huynguyen6923-hub/Huy_K26/pictures/Screenshot 2026-04-20 142424.png

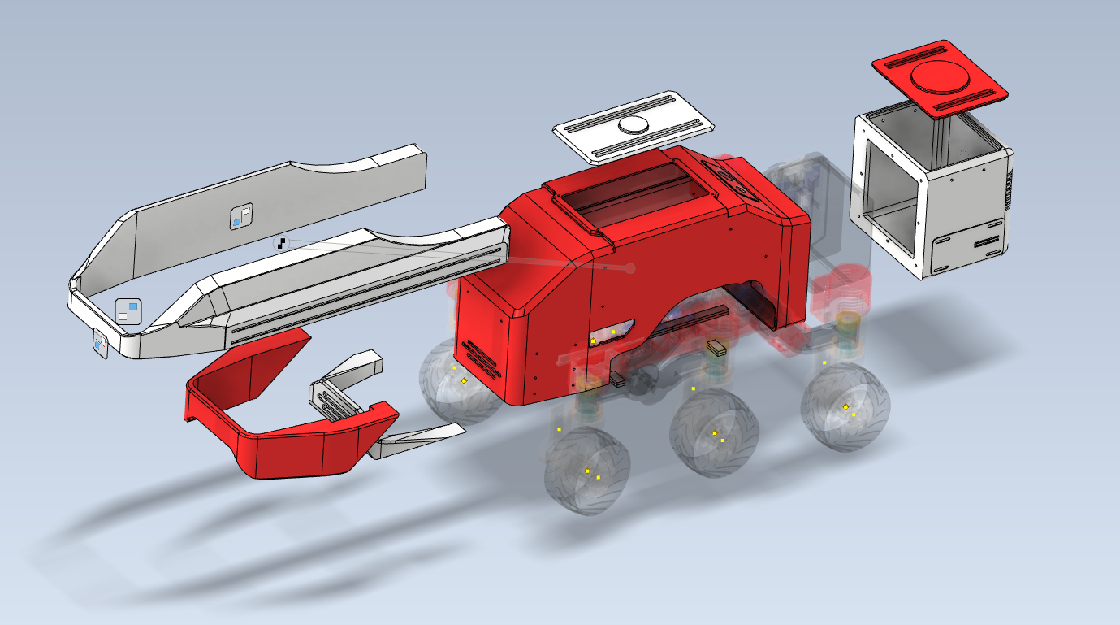
pictures/Screenshot 2026-04-20 142424.png
