huynguyen6923-hub/Huy_K26/(commit log)

2026-01-04 intit project
    [pyvenv.cfg]
2026-06-01 init project
    [pyvenv.cfg, servo_calibration.json]
